mishafarms/RFID_Ble/README.md

# RFID_Ble
BLE RFID reader

Here is a link to the PCB for this design. https://oshpark.com/shared_projects/lGCXMxED
