mishafarms/RFID_Ble/Hardware/RFID_bmd200.brd

## EAGLE design Hardware/RFID_bmd200.brd (2016-02-24)

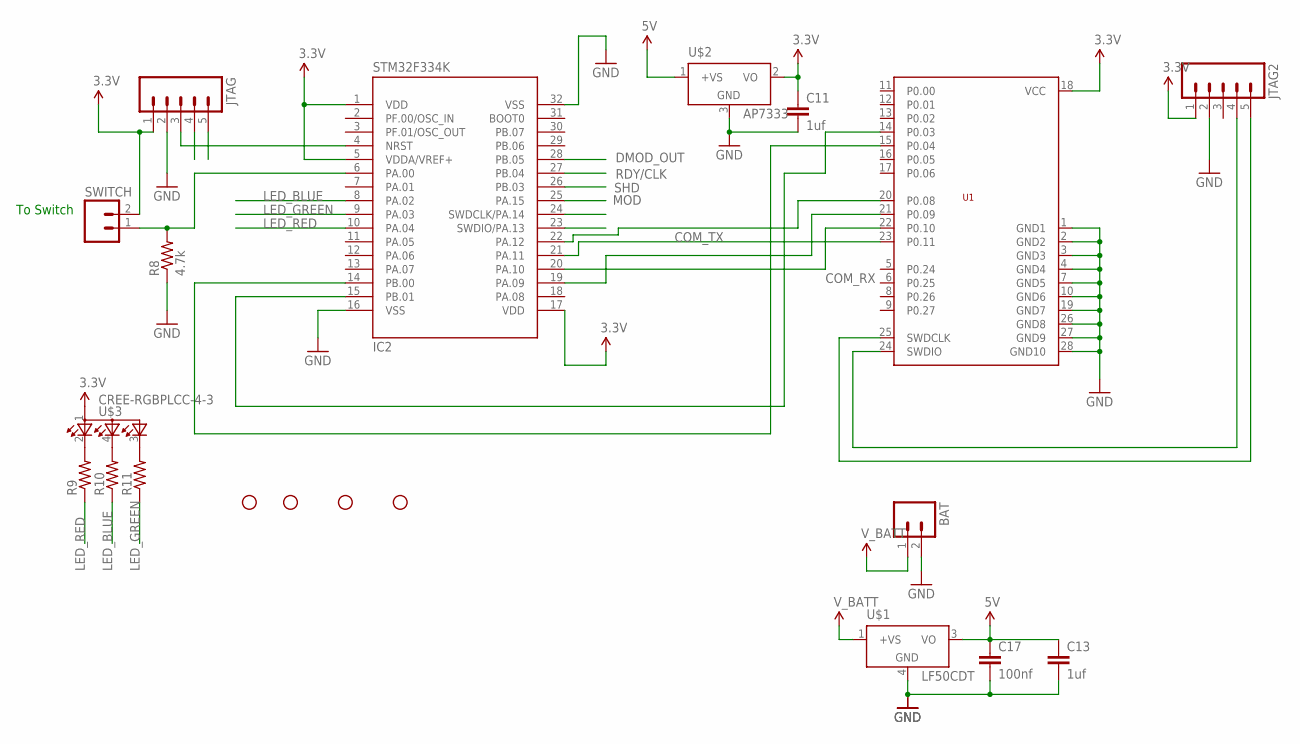
[picture p1: schematic RFID_bmd200.sch, sheet 1]

Parts:
BAT: M02PTH; 1X02
C11, C13: 1uf; 0805
C17: 100nf; 0805
IC2: STM32F334K; LQFP-32
JTAG, JTAG2: M05PTH; 1X05
R8: 4.7k; 0805
R9, R10, R11: RESISTOR0805-RES; 0805
STANDOFF1, STANDOFF2, STANDOFF3, STANDOFF4: STAND-OFF
SWITCH: M02PTH; 1X02
U1: BMD-200
U$1: LF50CDT; DPACK_3
U$2: AP7333; SOT23-3
U$3: CREE-RGBPLCC-4-3; P-LCC-4-3

Connections:
3.3V: C11.1, IC2.1 (VDD), IC2.5 (VDDA/VREF+), IC2.17 (VDD), JTAG.1, JTAG2.1, SWITCH.2, U1.18 (VCC), U$2.2 (VO), U$3.1 (A2)
5V: C13.1, C17.1, U$1.3 (VO), U$2.1 (+VS); also elsewhere on the board
COM_RX: IC2.20 (PA.10), U1.22 (P0.10)
COM_TX: IC2.19 (PA.09), U1.21 (P0.09)
DMOD_OUT: IC2.28 (PB.05); also elsewhere on the board
GND: BAT.2, C11.2, C13.2, C17.2, IC2.16 (VSS), IC2.32 (VSS), JTAG.2, JTAG2.2, R8.1, U1.1 (GND1), U1.2 (GND2), U1.3 (GND3), U1.4 (GND4), U1.7 (GND5), U1.10 (GND6), U1.19 (GND7), U1.26 (GND8), U1.27 (GND9), U1.28 (GND10), U$1.4 (GND), U$2.3 (GND); also elsewhere on the board
LED_BLUE: IC2.8 (PA.02), R10.1
LED_GREEN: IC2.9 (PA.03), R11.1
LED_RED: IC2.10 (PA.04), R9.1
MOD: IC2.25 (PA.15); also elsewhere on the board
unnamed: IC2.6 (PA.00), R8.2, SWITCH.1
unnamed: IC2.22 (PA.12), U1.20 (P0.08)
unnamed: IC2.21 (PA.11), U1.23 (P0.11)
unnamed: IC2.15 (PB.01), U1.14 (P0.03)
unnamed: JTAG2.5, U1.25 (SWDCLK)
unnamed: JTAG2.4, U1.24 (SWDIO)
unnamed: IC2.14 (PB.00), U1.15 (P0.04)
unnamed: R9.2, U$3.2 (CRED)
unnamed: R10.2, U$3.4 (CBLUE)
unnamed: IC2.4 (NRST), JTAG.3
unnamed: R11.2, U$3.3 (CGREEN)
RDY/CLK: IC2.27 (PB.04); also elsewhere on the board
SHD: IC2.26 (PB.03); also elsewhere on the board
STM_SWDCLK: IC2.24 (SWDCLK/PA.14), JTAG.5
STM_SWDIO: IC2.23 (SWDIO/PA.13), JTAG.4
V_BATT: BAT.1, U$1.1 (+VS)

Notes on the sheet:
To Switch

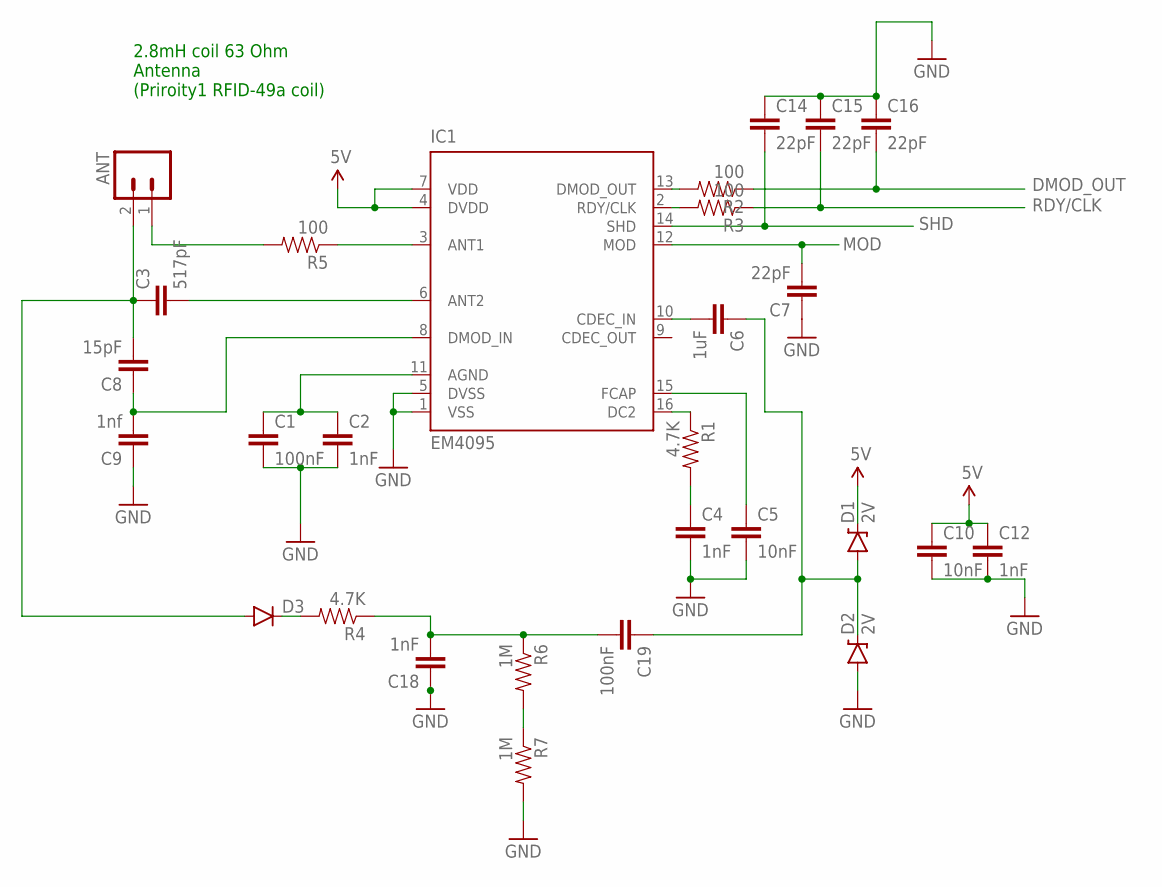
[picture p2: schematic RFID_bmd200.sch, sheet 2, RFid chip module]

Parts:
ANT: M02PTH; 1X02
C1: 100nF; 0805
C2, C4, C12, C18: 1nF; 0805
C3: 517pF; 0805
C5, C10: 10nF; 0805
C6: 1uF; 0805
C7, C14, C15, C16: 22pF; 0805
C8: 15pF; 0805
C9: 1nf; 0805
C19: 100nF; C1812
D1, D2: 2V; SOD-123
D3: DIODESMF; SMF
IC1: EM4095; SO16
R1, R4: 4.7K; 0805
R2, R3, R5: 100; 0805
R6, R7: 1M; 0805

Connections:
5V: C10.1, C12.1, D1.C, IC1.4 (DVDD), IC1.7 (VDD); also elsewhere on the board
ANT1: ANT.1, R5.2
DMOD_OUT: C16.2, R2.1; also elsewhere on the board
GND: C1.2, C2.2, C4.2, C5.2, C7.1, C9.1, C10.2, C12.2, C14.1, C15.1, C16.1, C18.1, D2.A, IC1.1 (VSS), IC1.5 (DVSS), R7.2; also elsewhere on the board
MOD: C7.2, IC1.12 (MOD); also elsewhere on the board
unnamed: IC1.13 (DMOD_OUT), R2.2
unnamed: IC1.2 (RDY/CLK), R3.2
unnamed: C6.2, IC1.10 (CDEC_IN)
unnamed: R6.2, R7.1
unnamed: C5.1, IC1.15 (FCAP)
unnamed: C4.1, R1.2
unnamed: IC1.16 (DC2), R1.1
unnamed: IC1.3 (ANT1), R5.1
unnamed: C3.2, IC1.6 (ANT2)
unnamed: ANT.2, C3.1, C8.2, D3.P$2 (A)
unnamed: C1.1, C2.1, IC1.11 (AGND)
unnamed: C8.1, C9.2, IC1.8 (DMOD_IN)
unnamed: C18.2, C19.2, R4.1, R6.1
unnamed: C6.1, C19.1, D1.A, D2.C
unnamed: D3.P$1 (C), R4.2
RDY/CLK: C15.2, R3.1; also elsewhere on the board
SHD: C14.2, IC1.14 (SHD); also elsewhere on the board

Notes on the sheet:
2.8mH coil 63 Ohm Antenna (Priroity1 RFID-49a coil)

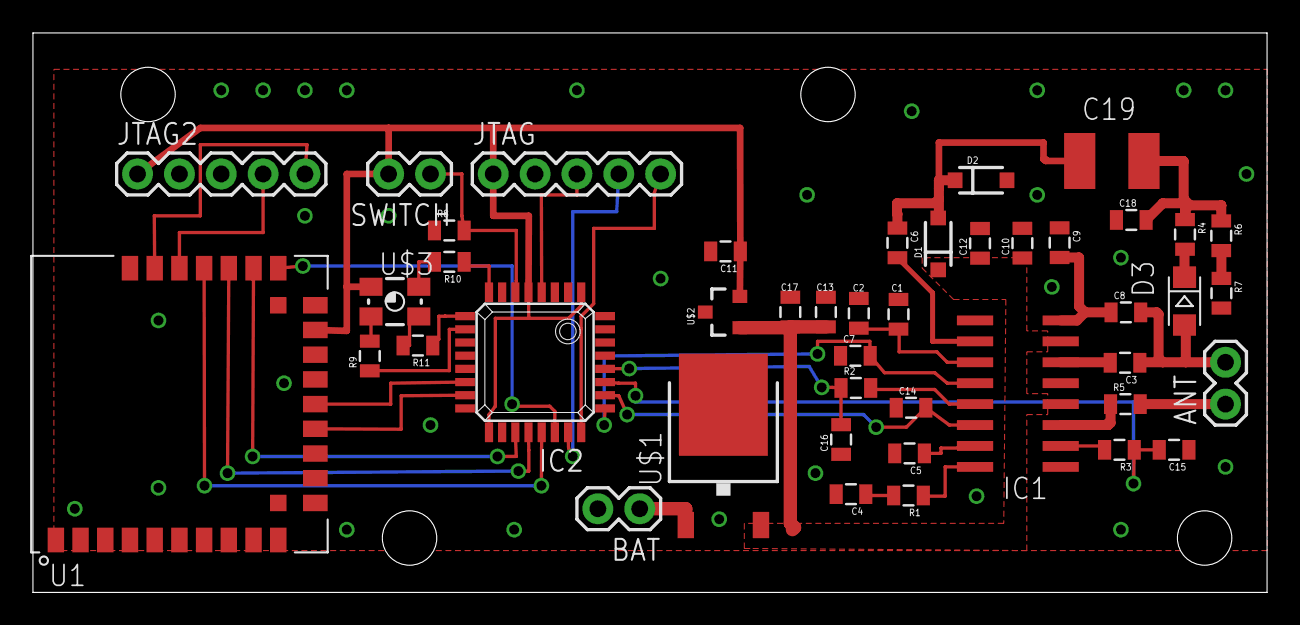
[picture p3: board RFID_bmd200.brd from above]

Board: 2 copper layers, 74.9 x 34.0 mm, 48 parts (0 on the bottom side), 42 nets.
