mishafarms/RFID_Ble/(commit log)

2016-02-24 Added files via upload
    Initial board design. Already we need version 0.2
    [RFID_bmd200.brd, RFID_bmd200.sch]
2016-02-24 moved these files to hardware directory
    [RFID_bmd200.brd, RFID_bmd200.sch]
2016-02-24 moved these
    [RFID_bmd200.brd, RFID_bmd200.sch]
2016-02-24 fixed some missing grounds and changed to the RTS pin on the STM32F334
    [RFID_bmd200.brd, RFID_bmd200.sch]
2016-02-24 moved RFID to the correct project path for the discovery board builds
    [animal.c, button.c, capture.c, main.c, rfid.h, timer.c, usart.c]
2018-03-13 add a link to the PCB
